upnorthmedia/helm/helm/bridge/README.md

# Helm host bridge

The program on the Mac that sits between the Helm deck and firstmate and herdr. The deck stays thin: it draws the `Model` the bridge sends and reports key and knob `Event`s (see `helm/contract.py`). Design decisions: [docs/research/README.md](../../docs/research/README.md#decisions).

## Run it

```sh
# One Model as JSON from the firstmate home, read only, then exit
FM_HOME=~/path/to/firstmate python3 -m helm.bridge --once

# What the firstmate home is missing for Helm, one line per check, read only, then exit
FM_HOME=~/path/to/firstmate python3 -m helm.bridge --doctor

# Against the deck or the simulator (dry run: note, focus, and open commands are logged, not run)
python3 -m helm.bridge --port /dev/ttys012

# JSON lines on stdin and stdout instead of the serial frame, for poking by hand
python3 -m helm.bridge --port -

# Send real inbox notes, focus real herdr panes, and open boards and reports
python3 -m helm.bridge --port /dev/cu.usbmodem1101 --live

# Say "firstmate has not picked this up" after 5 minutes instead of 3
python3 -m helm.bridge --port /dev/cu.usbmodem1101 --live --stall-after 300
```

Python 3.11 or newer, standard library only. `--port <path>` uses `helm.wire.open_transport(path)`, the serial and pty transport with the Harness Pro binary frame, which comes with the device and wire protocol work. `--home` defaults to `$FM_HOME`; with neither, the bridge exits and says to pass one.

Tests: `python3 -m unittest discover -s tests -t .`

`--doctor` (`doctor.py`) prints one line per check, `ok`, `warn`, or `missing`, with the fix: the home's shape, `fm-inbox.sh ready` and `can_receive`, each home's summary and its `valid`, each home's `config/fleet-ledger` and `config/pr-health-monitor`, herdr, the context tokens, `quota-axi`, `lavish-axi`, and whether the YES rule's opening words are in `data/captain.md`. It exits 1 only when a required piece is missing (the home, `ready`, or the primary's summary). It runs only `fm-inbox.sh ready`, `herdr agent list`, and the usage read, through a runner that refuses writes, never runs `lavish-axi`, and never writes a file. What each check means and how to fix it: [docs/firstmate-setup.md](../../docs/firstmate-setup.md).

One test also runs the note path against firstmate's own `bin/fm-inbox.sh`: set `HELM_FIRSTMATE_CHECKOUT` to a firstmate checkout (it is only read; the test links its `bin/` into a throwaway home). Without the variable that test is skipped.

## What it reads (never writes)

| Source | How often |
| --- | --- |
| `state/home-summary.json` and `state/pr-health.json` in each home | mtime check every 2 s |
| `state/fleet-ledger.jsonl` in each home, when present | every loop step, new lines only |
| `bin/fm-inbox.sh ready` (primary) | every 15 s |
| `bin/fm-inbox.sh receipts [--after <cursor>]` (primary) | every 5 s, only while a note is waiting for a reply; once at start in `--live`; once when a press replays a note |
| `herdr agent list` (also the context gauge), when herdr is installed | every 3 s |
| `/usr/sbin/ioreg -n Root -d1 -a` (is the Mac locked) | every 3 s, and again right before acting on a key |
| `quota-axi --provider claude --json --no-credential-refresh` | every 5 min, on a thread |
| `state/<id>.meta` and `state/<id>.status` | when items are rebuilt, for the herdr pane and the item age; every task's meta, to tell firstmate's own panes from other agents |
| `lavish-axi` (the open Lavish sessions), `state/<id>.status`, and `data/<id>/report.md` | on a SHOW ME tap; `data/<id>/report.md` and any report path in an item's detail are also stat'ed when items are rebuilt, to light SHOW ME |

Homes are the primary plus every second mate listed in its `data/secondmates.md` (D19). Each item carries the label of its home (`primary` or the second mate's id).

### How the summary is read

`state/home-summary.json` is firstmate's `fm-secondmate-home-summary.v1` document (written by `bin/fm-home-summary-refresh.sh`). The bridge reads it the way the producer means it:

- **Workers.** A blocked or failed worker comes from `endpoints[]`, which carries every task's current state from `fm-crew-state.sh`. `active_children` lists only working tasks, so it is never used for problems. The item's text is the task's `holds[]` row, else the fleet ledger's status text. A second mate's endpoint is its home, not a worker, and is skipped. The working count is the `working` rows of `endpoints[]`, second mates excluded.
- **Validity.** When the summary says `valid: false`, the reason goes into `link.stale_reason` (`primary summary invalid: <reason>`) and the bridge log (once, when it appears or changes). The deck then follows firstmate's own reading. For an inventory mismatch (`orphan_in_flight`, `unowned_current`, `terminal_in_flight`: an in-flight task with no meta, a running task with no backlog row, or an in-flight task already done or failed, such as a finished worker waiting for its merge) firstmate keeps the home's state, so the deck can still be `calm`. For any other kind, or when the summary's own `state` is `unknown` (a task whose current state is unavailable), the deck is never `calm`: `unknown` unless something is new.
- **Omitted rows.** When `omitted[]` names `decisions_open` or `endpoints`, the list ends with a row such as `+5 more decisions` (no keys, never new), and the decisions count includes them.
- **PR checks.** In order: a `contributions.captain[]` row with `hold: null` checked within the last 15 minutes (firstmate's own freshness bound) is green; firstmate writes such a row only after a fresh read found the PR mergeable with no failed or pending checks. Otherwise `state/pr-health.json` applies. That file records failures already reported and is never cleared when a re-run passes, so a report counts only for the commit the captain row names, and reads as "pr-health reported failing checks at this commit" in the item's text; with no captain row, any report counts. Anything else is unknown. YES is dark only when red.
- **Held PRs.** A captain row with `hold` set is there because of a captain hold, and its checks were never judged. It is not a ready PR: it joins the hold's decision (`decisions_open` lists it under the hold's task id), and a YES answers the hold, not "merge this PR".

## What it runs

Every command goes through one allowlist (`commands.py`): `fm-inbox.sh ready | receipts | note | announce`, `herdr agent list | focus`, `quota-axi --provider claude --json`, `ioreg -n Root -d1 -a`, and SHOW ME's three viewers. Anything else is refused before a process starts, which covers the report's never-call list. `note`, `announce`, `focus`, and the two viewer opens are refused unless the bridge was started with `--live`, on top of the dry-run switch in the intent code.

The viewers match a whole argv, not a prefix, and must be named bare (found on `PATH`):

- `lavish-axi` with no arguments, which lists the open Lavish sessions. A read.
- `open <url>` with exactly one argument: `http://127.0.0.1:<port>/session/<hex id>` (or `localhost`), or `https://github.com/<owner>/<repo>/pull/<n>`. No other host, scheme, path, or flag.
- `lavish-axi <page.html> [--reopen] [--no-gate]`, where the page is an absolute path to an existing `.html` file that, after symlinks, is inside the helm cache or a firstmate home's `data/` directory, and not under a dot directory (so `data/.secrets` is out). No other `lavish-axi` subcommand (`poll`, `share`, `end`, `stop`, ...) passes.

- A held YES, LATER, or HOLD becomes exactly one `fm-inbox.sh note --request-id <id> --json -- <text>` in the primary home. The request id is `helm-<intent>-<home>-<task>-<key>-<instance>-<YYYYMMDD>`, so pressing again the same day is a replay, not a second note. The instance is what makes a new ask on the same item: the first 12 characters of the PR's head commit, from the `head` of its `contributions.captain[]` row, and for a decision, `o<epoch>` from the first `[key=...]` line in `state/<task>.status` since that key was last resolved. A decision with no such line (a captain hold carries only a whole-day age) uses `q<8 hex>`, a digest of its question text. Long task or key names are cut first, so the id stays within 128 characters with the instance and day intact; a cut id also carries `h<8 hex>`, a digest of the whole uncut identity, so two items that differ only in the cut part (often the key) never share an id. Exit 3 (saved, wake failed) is repaired with `fm-inbox.sh announce`, never by sending again. YES is dark when the PR is known red or conflicted (see "PR checks" above).
- A replay of a note firstmate has already read shows "answered earlier", and its reply, old by definition, is labelled "earlier reply". `fm-inbox.sh note` can report a replayed note as not acknowledged once it was announced, so the bridge reads `receipts` to decide, falling back to the note's `handled/` path.
- Pending notes survive a restart. On start, a `--live` bridge reads `receipts` once and takes back its own notes (request id starting `helm-`) that have no reply and are less than a day old, then shows any reply to one of its notes that came in while it was down: the newest first, then up to five more in turn, newest first, each as the one before it lingers out. Every recovered reply is also logged. It reads replies with `receipts --after <cursor>`, keeping the cursor, with the home it belongs to, in `inbox-reply-cursor.json` in the helm cache. The first start with no cursor shows no old replies. A dry run takes nothing back and leaves the cursor alone.
- Every `key` event names the item the deck showed (`ref`), and the bridge acts on that item only, never on the last `select` it received: a lost `select` frame would otherwise turn a held YES onto an item the deck was not showing. A key whose ref is not a live item is refused with "that item is gone"; a key with no ref, as a deck flashed before `Key.ref` sends, is refused with "key named no item: update the deck". SHOW ME follows the same rule.
- The YES note begins with exactly `Captain, from the Helm deck, held to confirm: YES`, which a firstmate home with the YES rule treats as the captain's word for the one task, key, or PR it names (D14). The rule is each user's own opt-in, not firstmate's default; its text is in [docs/firstmate-setup.md](../../docs/firstmate-setup.md). It asks firstmate to merge under its normal checks if it is a merge ask, and otherwise to go with its single recommended option only if it gave exactly one (D15). When the item's PR has a known head, the merge ask reads ``merge `<url>` at commit `<40 character sha>` ``, the commit the deck showed. Firstmate's home rule passes it to `fm-pr-merge.sh --expected-head` and refuses if the PR has moved, so a push after the hold is never merged on that YES. Without a full SHA (a ledger stand-in, say) the note names the URL only. The bridge binds a held YES to the head it had when the hold began: the head as of the last model it sent, captured on the key's `down`, or, if that frame was lost, taken from the last model sent at `held`. If the summary has moved the head since, the YES is refused with "PR changed, look again: <item>" and nothing is sent; a fresh hold sends the new commit.
- The LATER note names the next local calendar date: ``defer `<task>` / `<key>` until 2026-11-12.``, so firstmate reading it after midnight still defers to the day the captain meant.
- A LATER or HOLD on an item whose YES is still waiting on firstmate's reply names that YES: ``This replaces my earlier YES on it (request `<request id>`).`` Firstmate may read the two notes in either order; the second one says which answer stands.
- **An answer's progress.** While a note waits on firstmate's reply, the model's `result` stays `queued` and carries `waited_s` (seconds since the note was sent), `seen` (receipts lists the note as `acknowledged`: firstmate has drained it, the "got it" step before the reply), and `stalled` (not seen after `--stall-after` seconds, 180 by default; firstmate drains its inbox when its current cycle ends, which can take minutes on a quiet fleet). When `fm-inbox.sh ready` reports `oldest_pending_note_age_seconds` (firstmate versions with https://github.com/kunchenguid/firstmate/pull/7602) and that read came after the note was sent, the bridge uses it too: `null` means the inbox was empty, so the note has been read and is not stalled; an older unread note means firstmate stopped draining that long ago, so the stall shows sooner. Without the field the note's own wait decides. `seen` is a flag beside `queued` rather than a new state because a deck refuses a state it does not know.
- **Which item has an answer out.** Each item carries `pending`, the answer (`yes`, `later`, or `hold`) still waiting on firstmate's reply for that item, the latest when there are two, so the deck says "YES sent" on it. A note counts only for the ask it was sent for: its request id must be the one the item would get for that answer on the day it was sent, so a new commit on the PR or a decision raised again shows nothing pending. Notes taken back at start find their item the same way. A reply clears it. A dry run sends nothing, so nothing is pending.
- SHOW ME (tap) runs `herdr agent focus <pane>` when the item has a pane: the worker's pane from `state/<id>.meta`, or firstmate's own pane for a decision (D17). Then, when the item has one, it opens the item's Lavish board, report, or PR in the browser (`show.py`). Focus goes first because it is instant; listing the Lavish sessions takes about 1.5 s. Resolution only reads, and the first match wins:
  1. **A live board.** A session `lavish-axi` lists whose id a board URL in the item's text names (its detail, which carries the hold or decision text, or the task's newest 20 status lines), or whose file is a report path the item names, or the newest session whose file sits in the task's own `data/<task>/` directory. It opens with `open` on `127.0.0.1` and the session's port, whatever host the text or the listing names, so a URL in a status line never sends the browser anywhere else. A board URL whose session is no longer listed is skipped.
  2. **The report**, in the item's own home: a `data/...` `.md` or `.html` path the item names, else `data/<task>/report.md`. Paths outside that home's `data/`, through a symlink out of it, or under a dot directory are ignored. An HTML report opens with `lavish-axi` as it is. Markdown is rendered (`report_html.py`, standard library only, every piece of text escaped) to one self-contained page per home, task, and report in the helm cache (`~/Library/Caches/helm/reports/`, or `$XDG_CACHE_HOME/helm` off macOS), re-rendered on every tap, and opened with `lavish-axi <page> --reopen --no-gate`: a tap is an explicit ask, so it reopens a board the captain ended and skips Lavish's layout curtain. Images beside the report are embedded (up to 8 MB each, 24 MB in all); others show as a labelled placeholder. The bridge refuses to write a page under a firstmate home.
  3. **The PR**, `open https://github.com/...`, for an item with a PR and no board or report.
  4. Otherwise focus only, as before. herdr items always only focus.

  Without herdr installed (`herdr agent list` exits 127, as on a home that uses firstmate's default tmux backend), no item names a pane, SHOW ME only opens a board, report, or PR, and nothing reports a fault. A herdr that is installed but failing still reads `herdr unavailable`.

  In a dry run the Lavish listing still runs (it is a read), the open command is logged, and no page is written. The result says what happened, for example `opening board for widget-pricing` or `dry run: report for widget-pricing logged`. The deck shows no result screen for SHOW ME today, so the contract is unchanged: the result text is for the bridge log and any later screen. SHOW ME is lit when the item has a herdr pane or something to open: a PR URL, a Lavish board URL or `data/...` report path in its detail, or `data/<id>/report.md` in its home (a stat per item rebuild; the rebuild never lists Lavish sessions or reads status lines, so a board found only that way opens on a tap but does not light the key alone). An item with no pane skips the focus and only opens. It stays dark when there is nothing to focus or open.

## Attention

The light means something new since the captain last touched the deck (D2). Everything open when the bridge starts is the baseline and counts as seen. A new decision, a PR waiting on the captain, or a blocked herdr agent makes the deck `new` and sets `chime` on the next Model only. Any touch (key, knob, select, seen) marks everything seen. The deck is `unknown` whenever firstmate's `can_receive` is not true, and is never `calm` on a summary firstmate itself reads as unknown. Seen state lives in the bridge only.

A blocked or failed firstmate task is firstmate's to handle first, so it lights the deck at once but chimes only if it is still stuck 10 minutes later; then it lights again, even if it was seen, and chimes once. The 10 minutes count from the fleet ledger's event when there is one, else from when the bridge saw it. A herdr agent waiting on an approval or question raises no item of its own when its pane belongs to a firstmate task (the `herdr_pane_id` in any task's meta, or a `fm_task` pane token naming a known task): firstmate's watcher sees the same transition. An agent the captain started by hand still chimes at once.

With the fleet ledger on, a `needs-decision`, `blocked`, `failed`, or `pr_ready` record shows its item right away, before the summary republishes; the summary takes over once it is published after the event. A blocked or failed stand-in stays while the summary still shows the task stuck, so its text and time carry over. Turning the ledger on backfills history, so the bridge starts at the end of the file and ignores records older than 10 minutes. Without the ledger, new items come from diffing successive summaries.

A green sweep on merge has no field of its own in the contract: the device can sweep when `counts.landed_today` goes up.

## Usage gauge, away mode, projects

These three need no firstmate change and add fields with defaults (`Model.usage`, `Link.away`, `Item.project`), so an older deck ignores them and a newer deck reads an older bridge's models as "unknown", "not away", and "no project".

- **Usage gauge.** `usage` carries what is left of the Claude 5 hour and weekly windows (`five_hour_left`, `week_left`, percent, rounded down) and the seconds until each resets, from `quota-axi`. Only a `fresh` reading counts: quota-axi missing, failing, timed out, not signed in, or serving a cached (`stale`) reading leaves every value null, which the deck shows as unknown, never full. The deck shows the gauge as a line on Home and on the calm light bar (lights for what is left of the tighter window, none lit while unknown). A reading older than 15 minutes is dropped too. quota-axi asks the vendor and can take seconds, so it runs on a thread and models keep flowing. `--no-credential-refresh` keeps the bridge from renewing a session itself. On macOS, quota-axi reads Claude's credentials from the Keychain only after `quota-axi --allow-keychain-prompt` has been run once by hand (approve with "Always Allow"); until then the bridge logs `claude quota auth_required (keychain_prompt_required)` and the gauge reads unknown.
- **Follow away mode.** While `fm-inbox.sh ready` reports posture `away`, `link.away` is true: the bridge drops YES, LATER, and HOLD from every item (so even an older deck keeps those keys dark), refuses a held one with "keys locked: firstmate is away", and sends no chime. SHOW ME still works, and the light bar still shows new items. In posture `quiet` the bridge only sends no chime: firstmate treats a quiet captain as present and acts on their word at once, and a captain inbox note still wakes it (the away-mode daemon escalates every `check` wake), so YES, LATER, and HOLD keep working and the status strip reads `firstmate quiet`. A chime suppressed while away or quiet does not ring on return. Posture `unknown` is not away.
- **Projects.** `project` names the repo an item belongs to: the active child's `repo` for its task, else the basename of the `project` path in the task's meta (not for a second mate, whose meta names its own checkout), else the repository in its PR URL. Captain holds and herdr agents usually have none. The deck's knob filters the list by it.

## Context gauge, Mac lock, project tints

The same rule holds here: new fields have defaults (`Model.context`, `Link.mac_locked`), both decoders treat them as optional, and the 8192-byte frame still fits (tested).

- **Context gauge.** herdr itself does not count tokens: each agent's `tokens` is a map of short strings that herdr integrations report for the sidebar. The usagebar plugin (senna-lang/herdr-agent-usage) writes `tokens.context` as `⛁ 49% (492k)` (percent of the window used, then tokens), with `⚠️` from 80 %, narrower `49% (492k)` or `49%`, or `5h 72% · ⛁ 14% (136k)` with several Claude accounts. `context.py` reads the percent from those forms only; `compacted (31k)`, a bare token count, no token, or no usagebar is unknown. `context` carries the fullest agent's percent (`top_used`) and name (`top_agent`, its title token, else its terminal title, else its pane), and how many agents are at 80 % or more (`near_limit`, usagebar's own warning threshold). No reading at all, or herdr unavailable, leaves all three null: unknown, never empty. The deck shows a line on Home, amber while any agent is near, and turns the last light of the calm bar amber.
- **Lock keys when the Mac is locked.** `lock.py` reads `ioreg -n Root -d1 -a` (read only, in every macOS install; about 22 ms with the plist parse) every 3 s: the session counts as locked when the registry root's `IOConsoleLocked` is true, or this user's session in `IOConsoleUsers` has `CGSSessionScreenIsLocked` true or `kCGSSessionOnConsoleKey` false (another user has the console). The user id and on-console keys are public (CoreGraphics `CGSession.h`); `IOConsoleLocked` and `CGSSessionScreenIsLocked` are not documented by Apple. While locked, `link.mac_locked` is true, the bridge drops every action from every item (SHOW ME too, so even an older deck keeps every key dark), and refuses a held key or a SHOW ME tap with "keys locked: the Mac is locked", reading the lock again first so a lock since the last poll still counts. Chimes still ring and new items still light: the deck still tells you something is waiting. Limits: a display that sleeps without locking is not detected (Apple silicon has no `IODisplayWrangler`); set "Require password after screen saver begins or display is turned off" to immediately so a display sleep locks. Unknown (no ioreg, as off macOS, or output it cannot read) leaves the keys unlocked, as before, and is logged once.
- **Project tints.** The deck tints each unseen item's light, and its list row's color strip, by project. The rule that keeps firstmate's kind colors readable: a tint never changes the hue, it only mixes white into the kind's color (0 % with no project, else 18, 36, or 54 % from a 32-bit FNV-1a hash of the name), so red, amber, blue, and green always read as themselves. Hue tints were tried and dropped: red and amber are 38 degrees apart, and every hue but cyan pulls one toward the other. The bridge sends nothing new for this; the deck derives it from `Item.project`. See `firmware/core/helm_lights.h`.
