upnorthmedia/helm/docs/sim/home-unknown.png

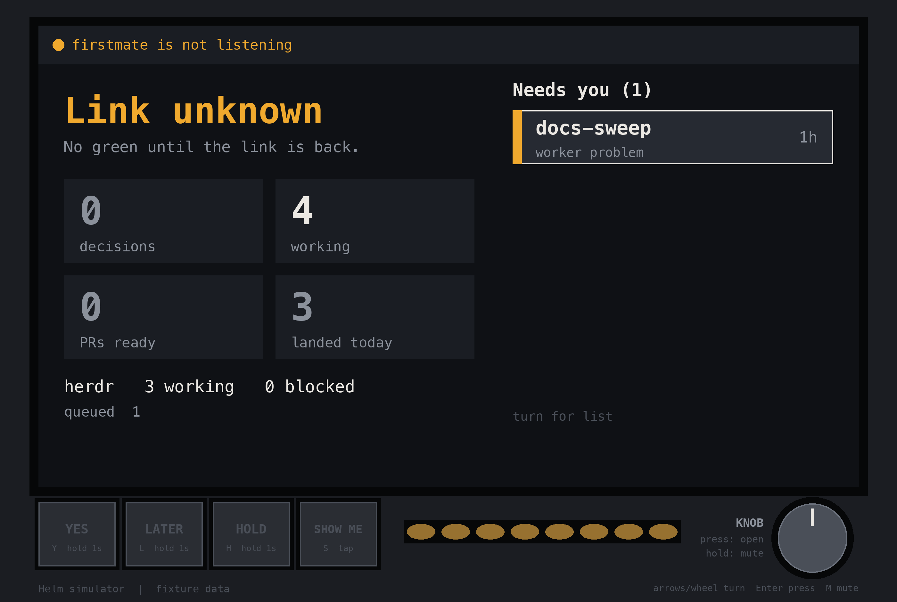
docs/sim/home-unknown.png
