upnorthmedia/helm/docs/sim/home-view.png

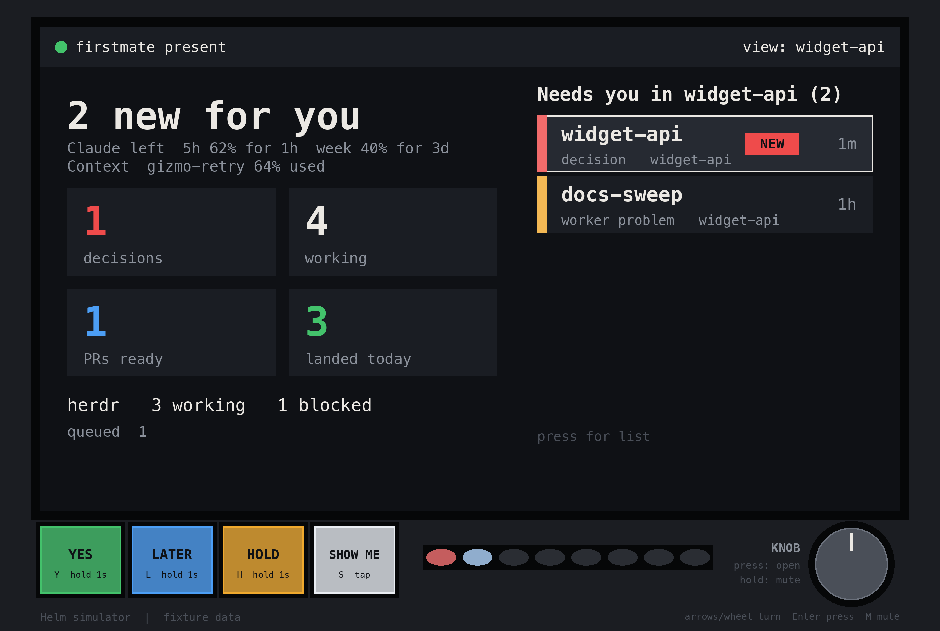
docs/sim/home-view.png
