upnorthmedia/helm/docs/sim/list-view.png

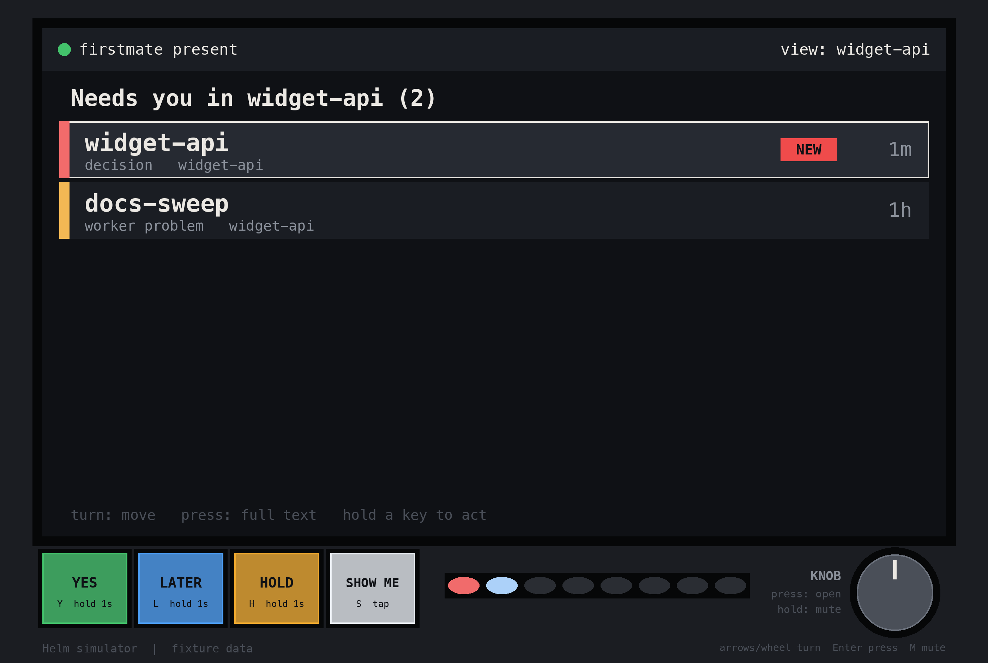
docs/sim/list-view.png
