upnorthmedia/helm/case/logo/logo-h1-wheel-helm.dxf

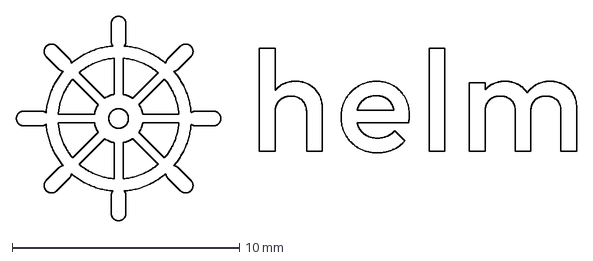
[picture p26: CAD file, 2026-11-11]
case/logo/logo-h1-wheel-helm.dxf
24.7 x 9.00 mm
