upnorthmedia/helm/case/out/dxf/mx_coupon.dxf

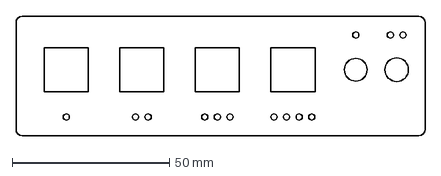
[picture p27: CAD file, 2026-11-11]
case/out/dxf/mx_coupon.dxf
130.0 x 38.0 mm
