upnorthmedia/helm/case/out/step/base.step

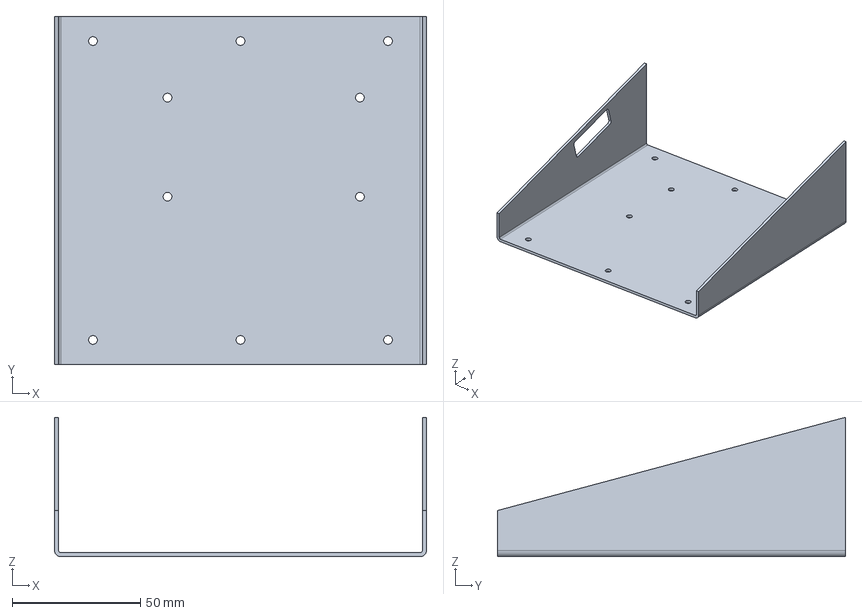
[picture p28: CAD file, 2026-11-11]
case/out/step/base.step
145.0 x 135.7 x 54.4 mm
