upnorthmedia/helm/case/out/stl/print_cradle.stl

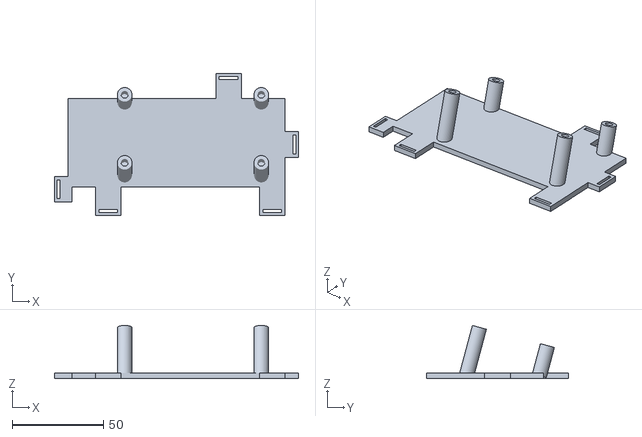
[picture p29: CAD file, 2026-11-11]
case/out/stl/print_cradle.stl
133.9 x 77.7 x 29.1
