upnorthmedia/helm/case/out/dxf/base_flat.dxf

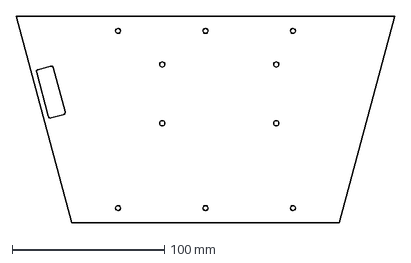
[picture p30: CAD file, 2026-11-11]
case/out/dxf/base_flat.dxf
248.7 x 135.7 mm
