upnorthmedia/helm/case/out/engrave/face_logo_placement.dxf

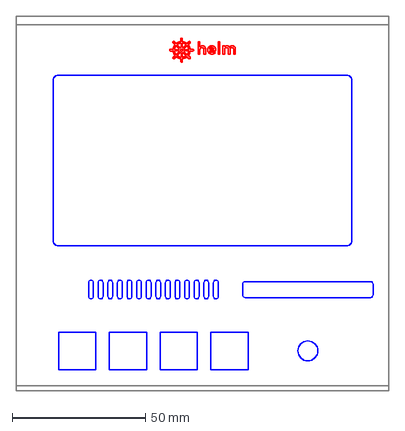
[picture p31: CAD file, 2026-11-11]
case/out/engrave/face_logo_placement.dxf
139.6 x 140.5 mm
