upnorthmedia/helm/case/out/step/cover.step

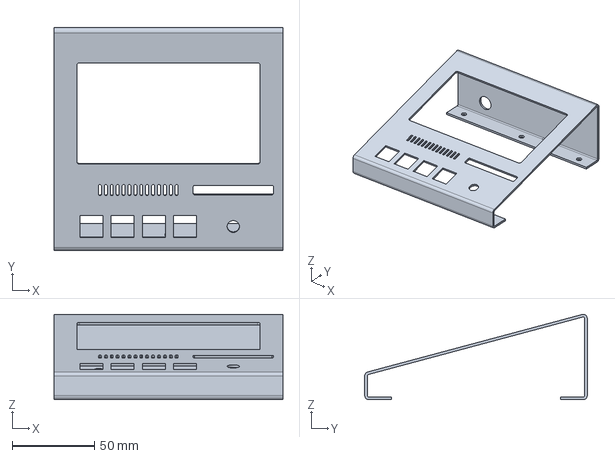
[picture p32: CAD file, 2026-11-11]
case/out/step/cover.step
139.6 x 135.7 x 52.0 mm
