upnorthmedia/helm/case/out/stl/print_cradle_tab.stl

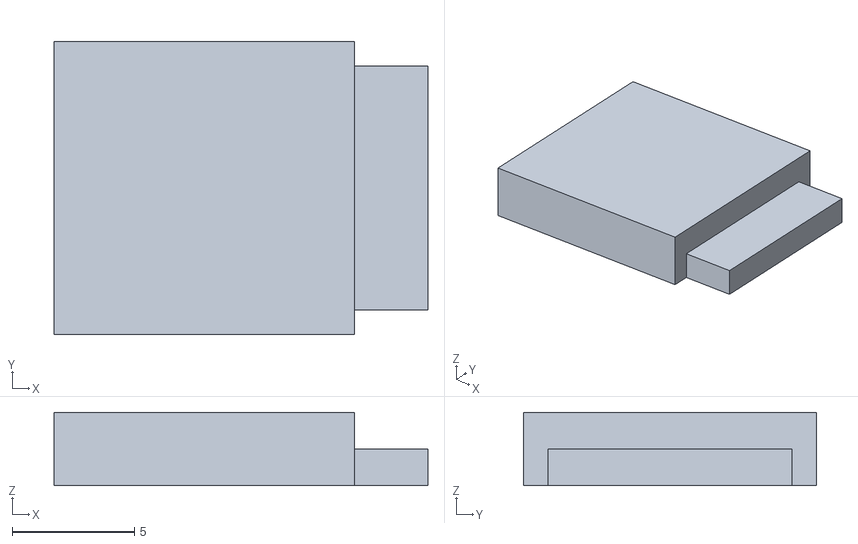
[picture p33: CAD file, 2026-11-11]
case/out/stl/print_cradle_tab.stl
15.3 x 12.0 x 3.00
