upnorthmedia/helm/case/out/dxf/cover_flat.dxf

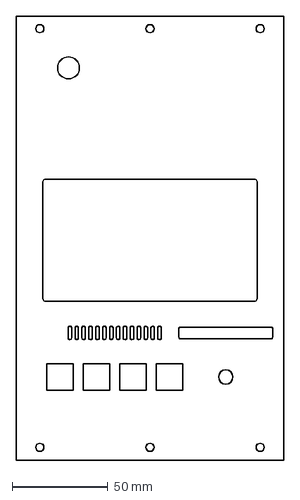
[picture p34: CAD file, 2026-11-11]
case/out/dxf/cover_flat.dxf
139.6 x 231.6 mm
