upnorthmedia/helm/case/out/stl/print_test_base.stl

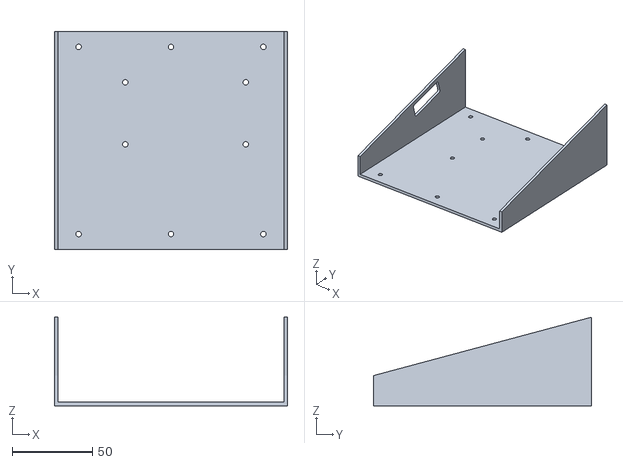
[picture p35: CAD file, 2026-11-11]
case/out/stl/print_test_base.stl
145.0 x 135.7 x 55.2
