upnorthmedia/helm/case/out/stl/print_test_cover.stl

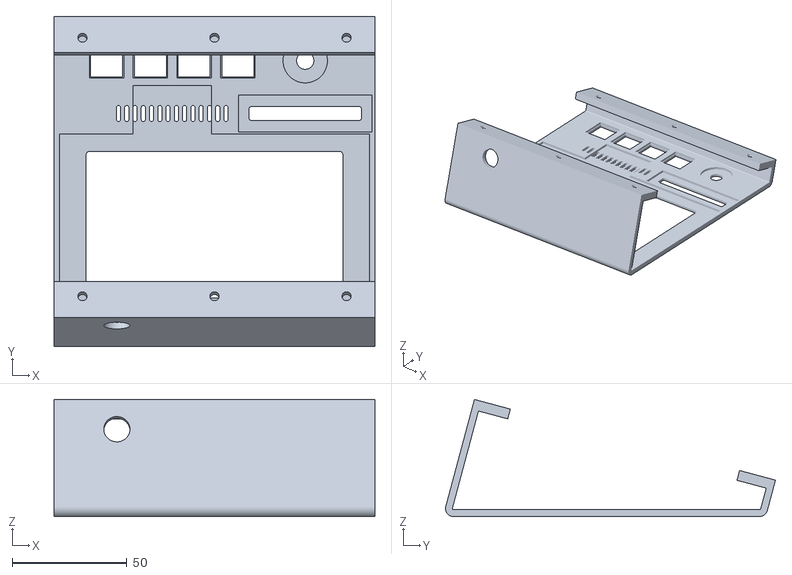
[picture p36: CAD file, 2026-11-11]
case/out/stl/print_test_cover.stl
139.6 x 143.7 x 51.0
