upnorthmedia/helm/case/out/stl/print_light_holder.stl

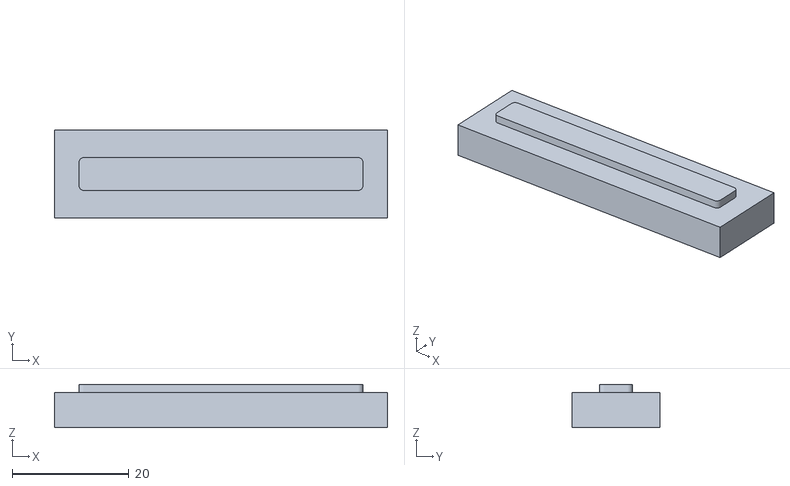
[picture p37: CAD file, 2026-11-11]
case/out/stl/print_light_holder.stl
57.0 x 15.0 x 7.40
