upnorthmedia/helm/case/out/stl/print_mx_coupon.stl

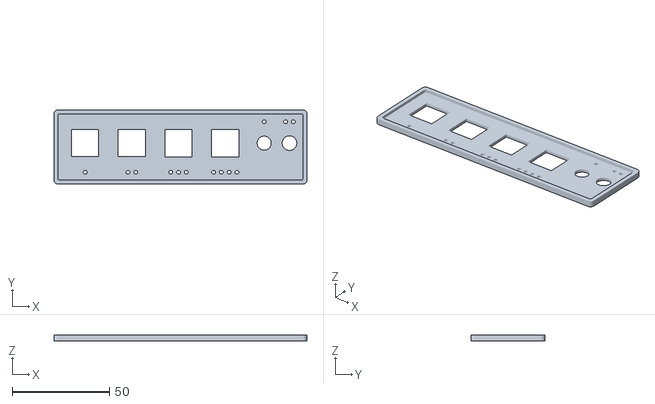
[picture p38: CAD file, 2026-11-11]
case/out/stl/print_mx_coupon.stl
130.0 x 38.0 x 3.00
