upnorthmedia/helm/case/out/stl/print_speaker_holder.stl

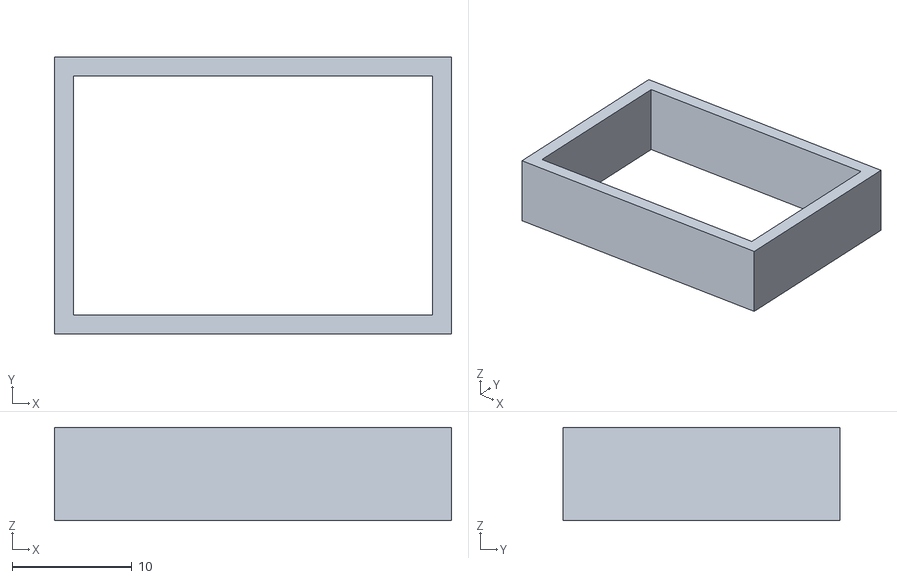
[picture p39: CAD file, 2026-11-11]
case/out/stl/print_speaker_holder.stl
33.2 x 23.2 x 7.80
