upnorthmedia/helm/docs/build/keycaps/hold.png

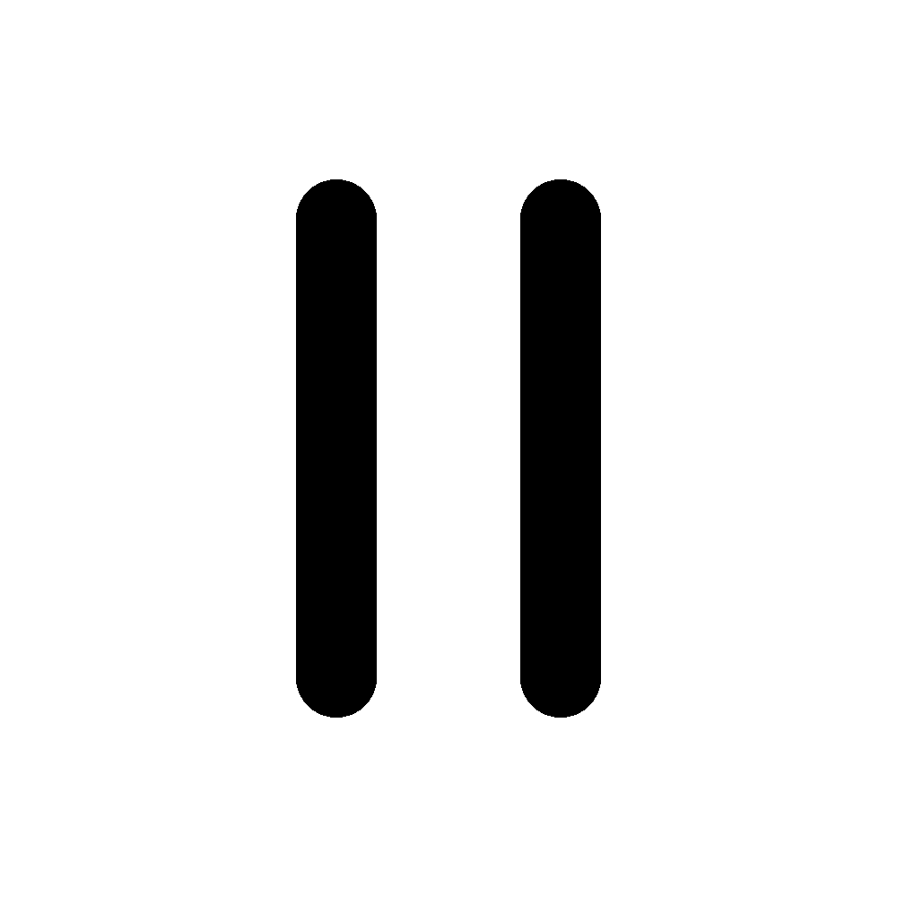
docs/build/keycaps/hold.png
