upnorthmedia/helm/docs/build/keycaps/later.png

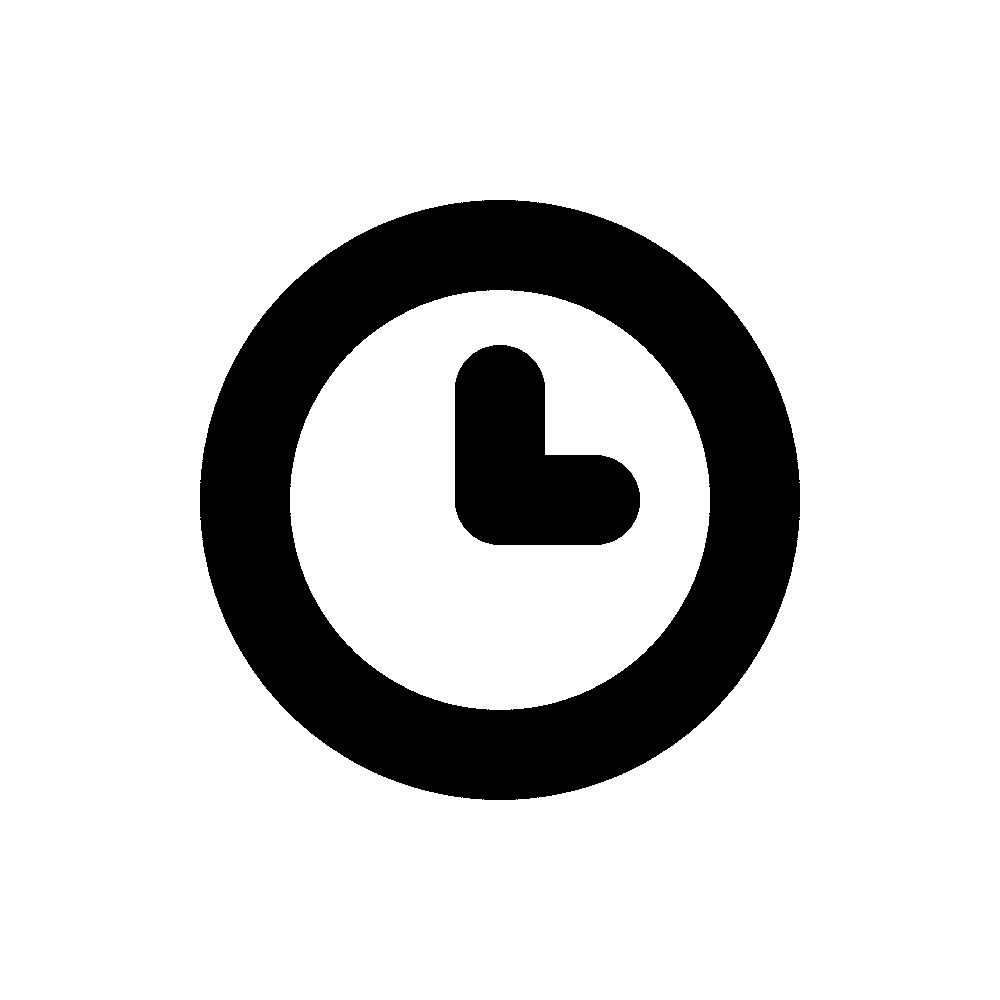
docs/build/keycaps/later.png
