upnorthmedia/helm/docs/build/keycaps/yes.png

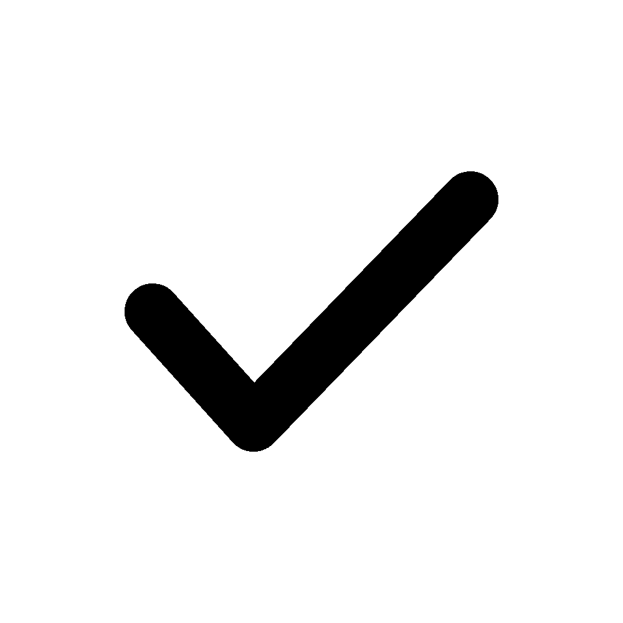
docs/build/keycaps/yes.png
