upnorthmedia/helm/(commit log)

2026-11-11 Helm: a desk control deck for firstmate and herdr
    [base.step, base_flat.dxf, bom.csv, cover.step, cover_flat.dxf, face_logo_placement.dxf, logo-h1-wheel-helm.dxf, mx_coupon.dxf]
2026-11-11 Rewrite the README as Helm's front page, with renders and simulator screens (#1)
    * Rewrite the README as Helm's front page, with renders and simulator screens
    Lead with the hero render, the one-line pitch, and the problem it solves.
    Explain every key, the knob, the light bar, and the chime; show the screen
    states from the simulator's fixture data; list the features, how the
    bridge, firmware, and simulator fit together, the build path, the
    simulator commands, and the project status. Keep the run and launch-agent
    instructions and the License section. Add a placeholder for the teaser
    video.
    Renders go under docs/images/ as web-sized JPEGs; the screenshots reuse
    docs/sim/, which python3 -m sim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
2026-11-11 Add the keycap icon art for the backlit caps (#2)
    Four icons (check mark, clock, pause bars, ring with a centre dot) as
    black-on-white SVG and 1-bit PNG files for Max Keyboard's custom backlight
    keycaps, drawn in code to match the renders, with a lit preview and the
    ordering steps. The build guide now names the ring for SHOW ME and links
    the art.
    [bom.csv]
2026-11-11 Light SHOW ME for items with a PR or report but no pane (#3)
    SHOW ME was lit only when an item had a herdr pane, so an item with a PR,
    a report, or a review board link but no pane could not open them from
    the deck. The key now lights when there is a pane to focus or something
    to open: a PR URL, a board URL or data/ report path in the item's
    detail, or data/<task>/report.md in its home (a stat per rebuild). The
    open order, the no-pane tap path, the allowlist, and dry-run rules are
    unchanged.
2026-11-11 Name the item in every key event, so a lost select cannot misdirect YES (#4)
    A key event named no item, and the bridge acted on the last select it had
    received. The deck drops frames the host is not reading, so a lost select
    left the bridge on the previous item: a held YES answered an item the deck
    was not showing.
    Key events now carry the ref of the item the deck showed (the selection,
    or the held item), and the bridge acts on that ref only. A ref that is no
    longer live is refused ("that item is gone"); a key with no ref, as a deck
    flashed before this change sends, is refused rather than falling back to
    the last select. SHOW ME follows the same rule. The bridge no longer keeps
    a selection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
    [codec.py, helm_deck.c, helm_event.c, helm_event.h, helm_model.h]
2026-11-11 Add a printed test enclosure and locating tabs for the module (#5)
    * Add a printed test enclosure and locating tabs for the module
    The printed test enclosure is a printed copy of the metal cover and base,
    so the whole deck can be fitted on the bench before the SendCutSend
    order. It keeps the metal parts' split, outside, holes and mounting
    positions. Walls thicken inward, and the face is pocketed back to the
    metal's 1.6 mm wherever a part bears on it, so every part sits where it
    does in the metal case and the same cradle and holders fit both. The
    cover's flanges take M3 x 4 heat-set inserts in place of the S-M3-0
    nuts, and the base's floor thickens downward so its top stays put. Each
    part pr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
    [print_cradle.stl, print_cradle_tab.stl, print_test_base.stl, print_test_cover.stl]
2026-11-11 feat(bridge): pin held YES to the commit, date LATER, and keep answers across restarts (#7)
    * feat(bridge): pin held YES to the commit and make answers restart safe
    - YES on an item with a known PR head says "merge <url> at commit <sha>",
    so firstmate can pass it as fm-pr-merge.sh --expected-head. The note's
    opening words are unchanged.
    - LATER names the next local date instead of "tomorrow".
    - The request id carries the item instance: the PR head for a PR, and for
    a decision the first status line for its key since it was last
    resolved (a digest of its question when there is none). A new push or
    a reopened decision is a new ask; the same ask again is a replay.
    - A replay of a note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
2026-11-11 fix(bridge): read firstmate's summary, PR state, and posture as firstmate publishes them (#9)
    * fix(bridge): read worker state, honesty fields, and PR verdicts as firstmate publishes them
    Stuck workers now come from endpoints[] (active_children holds only working
    tasks), with text from holds[] or the ledger, and a ledger stand-in stays while
    the summary still shows the task stuck. They light at once and chime only if
    still stuck ten minutes later. A waiting herdr pane that runs a firstmate task
    raises no item of its own.
    Working counts endpoints[]; omitted decisions and tasks show as +N more rows;
    an invalid summary is never calm and its reason goes in link.stale_reason.
    PR green comes fr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
    [helm_model.h]
2026-11-11 ci: add repo guardrails: no-mistakes gate, lint, macOS and case CI, contributor and security docs (#8)
    * style: fix what ruff and shellcheck flag
    Rename the ambiguous l variables, drop two unused test imports, turn a
    test lambda into a def, and mark the install script's literal tilde match
    as intended. case/build.py writes the same out/checks.txt as before.
    * ci: add a public repository hygiene guard
    scripts/check-hygiene.sh fails on a tracked file that holds a home
    directory path, an email address other than the repository's noreply
    author, or a line matching .github/hygiene-deny.txt. A private deny list
    kept outside the repository can be added with --deny. It runs on the
    stock macOS bas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
2026-11-11 feat(bridge): add --doctor, a firstmate setup guide, and as-built architecture docs (#10)
    * feat(bridge): add --doctor, a read-only check of what a firstmate home is missing for Helm
    One line per check (ok, warn, or missing) with its fix: the home's shape, fm-inbox.sh ready and can_receive, each home's summary and valid flag, each home's fleet-ledger and pr-health-monitor flags, herdr, context tokens, quota-axi, lavish-axi, and the YES rule's opening words in data/captain.md. Exits 1 only when a required piece is missing. It runs only the bridge's read commands through a runner that refuses writes, never runs lavish-axi, and writes no file.
    * docs: add the firstmate setup guide and as-buil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
2026-11-11 feat: show seen, wait time, stalls, and answers out on the deck (#11)
    * feat(contract): optional answer progress and per-item pending answer on the wire
    Result gains seen, waited_s, and stalled; Item gains pending (yes, later,
    or hold). All are optional keys, and no enum gains a value, so an older
    deck skips them and still shows the model. The C parser and the Python
    codec read them alike, and the cross-tests cover old and new frames.
    * feat(bridge): show when firstmate has read a held answer, how long it has waited, and which item has one
    Receipts' acknowledged marks a queued note seen. A note firstmate has not
    read after --stall-after seconds (default 180) is stalled; fm-inbox.sh
    ready'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
    [codec.py, helm_deck.c, helm_deck.h, helm_model.c]
2026-11-13 docs: add illustrated bench and printed-fit build manual (#12)
2026-11-13 fix(firmware): take the display lock through the adapter; record the first bench bring-up (#13)
    * fix(firmware): take the display lock through the adapter, not bsp_display_lock()
    The board package's bsp_display_lock() (1.0.4) returns esp_lv_adapter_lock()'s
    esp_err_t as a bool, so it reads false when it took the lock and true when it
    did not. app_main took the lock, skipped ui_init, and never released it; the
    deck task then rendered without the lock onto an unbuilt UI, leaving the screen
    white and the task watchdog firing in lv_obj_clean. display_lock() asks the
    adapter directly and checks for ESP_OK. Validated on the first LCD-5 board.
    * docs: record the first bench bring-up in the build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
    [main.c]
