upnorthmedia/helm/(notices)

Notices in the files:
docs/build/guide/index.html:
SPDX-FileCopyrightText: 2026 The Helm authors
SPDX-License-Identifier: CERN-OHL-W-2.0
README.md:
Code license: Apache-2.0
Hardware license: CERN-OHL-W-2.0
Docs license: CC BY 4.0
